OxygenDragon/solder-joint-detection/ARC_SDK/inc/model_data.h

#ifndef OXYGENDRAGON_SOLDER_DETECTION_MODEL_DATA_H_
#define OXYGENDRAGON_SOLDER_DETECTION_MODEL_DATA_H_

extern const unsigned char model_tflite[];
extern const int model_tflite_len;

#endif  // OXYGENDRAGON_SOLDER_DETECTION_MODEL_DATA_H_
