OxygenDragon/solder-joint-detection/(commit log)

2021-05-24 init commit
    [yolov4-custom.cfg, yolov4-tiny-custom.cfg]
2021-05-29 add img deployable to himax we-i plus
    [yolov4-custom.cfg, yolov4-tiny-custom.cfg]
2021-05-29 add arduino tft support
2021-07-14 add video support for camera, add program for showing uart outputs
2021-07-16 fix memory exception for image, modify model for smaller input
    [SerialOut.py, image_provider.cc, image_provider.h, main_functions.cc, model_settings.h]
2021-07-20 modify some small bugs
    [SerialOut.py, detection_responder.cc, image_provider.cc, image_provider.h, main_functions.cc, tft_display.ino]
2021-07-20 fix prediction transfer bug, can now correctly detect
    [SerialOut.py, image_provider.cc, main_functions.cc]
2021-07-22 change detection responder to make it sendable for i2c
2021-07-22 change arduino display decoding method
2021-07-23 add schematic diagram for README.md
2021-07-24 add device image, flow chart, modify serial out error message
    [SerialOut.py, tft_display.ino]
2021-08-03 fix arduino joystick bug
    [detection_responder.cc, detection_responder.h, image_provider.h, joystick_handler.cc, joystick_handler.h, main_functions.cc, main_functions.h, model_data.h]
2021-08-04 fix some compress image bug
    [SerialGUI.py, image_provider.cc, joystick_handler.cc, tft_display.ino]
2021-08-13 modify flowchart
